Vedant28082005/het_smart_agriculture/firmware/irrigation/config.h

// All hardware and tuning defaults live here.
#pragma once

// ---- Pins (ESP32 DevKit V1) ----
#define PIN_SOIL_AOUT   34   // ADC1 only; ADC2 breaks when Wi-Fi is on
#define PIN_DHT         4
#define ENABLE_FLOAT_SWITCH 0  // 0 = no float switch fitted: tank is assumed to have water
#define PIN_FLOAT       27   // to GND, INPUT_PULLUP
#define PIN_RELAY       26
#define PIN_STATUS_LED  2
#define ENABLE_BUZZER   0    // set to 1 to use the buzzer
#define PIN_BUZZER      25

// ---- Sensor type: 1 = DHT22, 0 = DHT11 ----
#define USE_DHT22 0

// ---- Relay polarity (unknown yet: bench-test in docs/wiring.md) ----
#define RELAY_ACTIVE_LOW 1
// 1 = switch OFF by releasing the pin (high-impedance) instead of driving HIGH. Fixes active-low
// modules that stay on when driven from 3.3 V. Only used when RELAY_ACTIVE_LOW is 1.
#define RELAY_OFF_HIGHZ  1

// ---- Float switch: level read while the tank HAS water ----
#define FLOAT_WATER_LEVEL LOW   // LOW = switch closed to GND = water present

// ---- Soil sensor ----
#define SOIL_SAMPLES        10
#define SOIL_RAW_MIN_VALID  50     // below = wire off / short
#define SOIL_RAW_MAX_VALID  4090   // above = floating / open
#define SOIL_DEFAULT_DRY    3200   // replaced by calibration (NVS)
#define SOIL_DEFAULT_WET    1400

// ---- Timing (ms) ----
#define SERIAL_PERIOD_MS    2000
#define DHT_FAIL_TIMEOUT_MS 30000  // DHT failing this long => sensor_ok=false

#define SERIAL_BAUD         115200

// ---- Network (credentials live in secrets.h, copy from secrets.example.h) ----
#define MQTT_PREFIX         "farm/field1"
#define MQTT_CLIENT_ID      "esp32-field1"
#define PUBLISH_PERIOD_MS   5000
#define WIFI_RETRY_MIN_MS   10000   // Wi-Fi reconnect backoff: 10 s doubling to 60 s
#define WIFI_RETRY_MAX_MS   60000
#define MQTT_RETRY_MIN_MS   1000    // MQTT reconnect backoff: 1 s doubling to 60 s
#define MQTT_RETRY_MAX_MS   60000
#define MQTT_SOCKET_TIMEOUT_S 2     // keeps a dead broker from stalling the control loop
#define NTP_SERVER          "pool.ntp.org"
#define HTTP_PORT           80
