Vedant28082005/het_smart_agriculture/firmware/irrigation/secrets.example.h

// Copy to secrets.h (gitignored) and fill in. Required from Phase 3 (the sketch will not compile without it).
#pragma once
#define WIFI_SSID     "your-ssid"
#define WIFI_PASS     "your-password"
#define MQTT_HOST     "192.168.1.10"
#define MQTT_PORT     1883
#define MQTT_USER     "irrigation"
#define MQTT_PASS     "change-me"
#define API_KEY       "change-me"
