Vedant28082005/het_smart_agriculture/(commit log)

2026-10-31 Phase 1: scaffold, sensor bench-test sketch, calibration, wiring docs
2026-10-31 Make float switch optional (ENABLE_FLOAT_SWITCH)
2026-10-31 Switch default sensor to DHT11
2026-10-31 Print DHT status string for diagnosis
2026-10-31 Phase 2: hardware-independent pump controller, relay polarity, serial control, unit tests
2026-10-31 Phase 4: ESP32 HTTP API with API key, helpers, tests and docs
2026-10-31 Enable DHT22, mDNS name, mosquitto prototype config
2026-10-31 Don't run pump control before the first sensor reading (false tank-empty alert at boot)
2026-11-02 Replace real Wi-Fi details in secrets.example.h with placeholders
    [secrets.example.h]
2026-11-02 Add start_all.bat to launch broker, backend and dashboard
    [config.h]
2026-11-02 Show command results immediately: store device status from command responses, ignore stale dashboard polls
2026-11-03 Release relay pin (high-Z) for OFF on active-low modules that stay on at 3.3V
2026-11-03 Apply RELAY_OFF_HIGHZ only for active-low relays
